har-in-air/FPGA_STEREO_CROSSOVER/(commit log)

2020-09-11 fix slave select initial setting
    [biquad.cpp, esp32_tas5753.ino]
2020-09-12 modify Audio class to update biquad on reading file samplerate
2020-09-13 reduce tas5753md modulation limit, check device id
2020-09-14 add conditional includes for Wifimulti.h and encoder
2020-09-15 crossover at 330Hz
2020-09-22 fix tap delay xover_iir.vhd
    [xover_iir.vhd]
2020-10-23 update filter diagram
2020-10-24 add button for next track
2020-11-18 change spi speed
2020-11-19 fix filename string size
    [esp32.ino]
2020-12-20 spi mode1 on esp32 and fpga slave
